mit-unicycle/mit-unicycle/docs/process/thanks.md

# Thanks

We want to warmly thanks Professor Christoph Koch, Federico Stella and the rest of the CS-358 TAs for the support and guidance they provided throughout the semester.  Also, many thanks to the staff of the SPOT. Without the help from all of this people, this project would have never come to fruition.

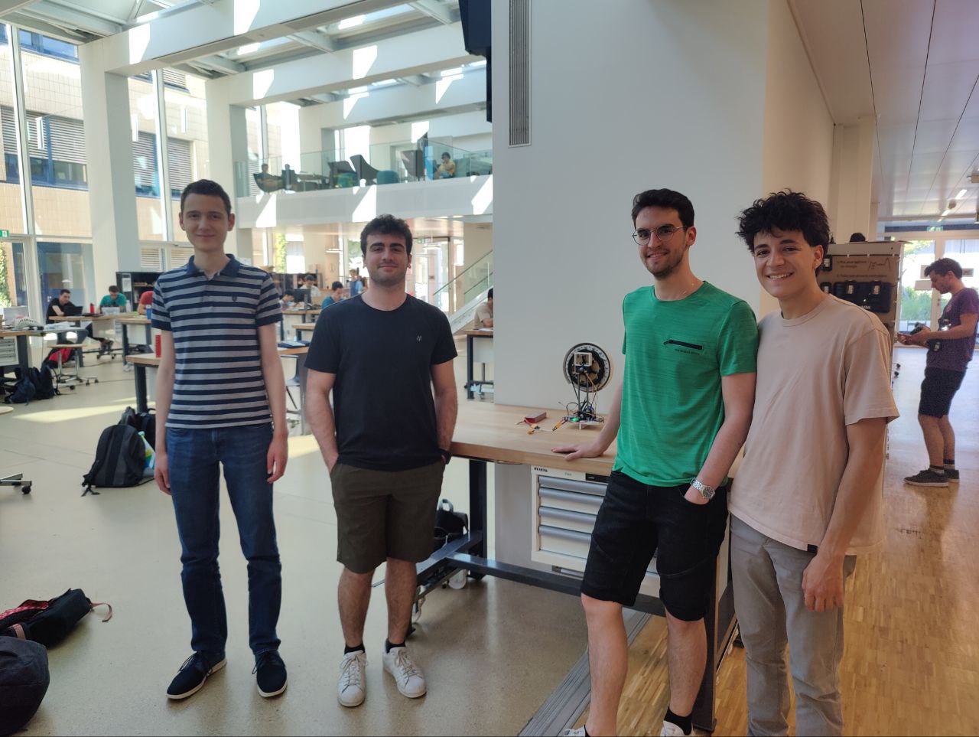
[picture p13: docs/images/dream_team.jpg]
The Dream Team


The Team being happy for the robot working just a few days before the deadline. 

----

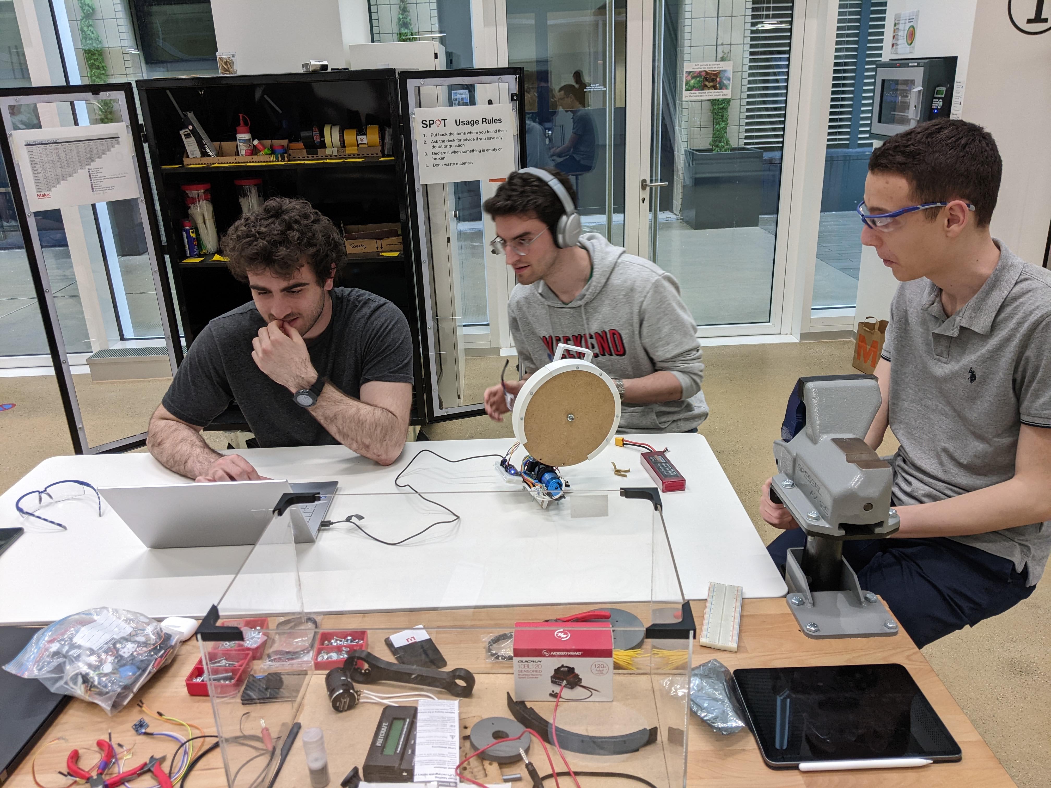
[picture p14: docs/images/dream_team_working.jpg]
The Dream Team Working


The Team Working Hard 🤓

----

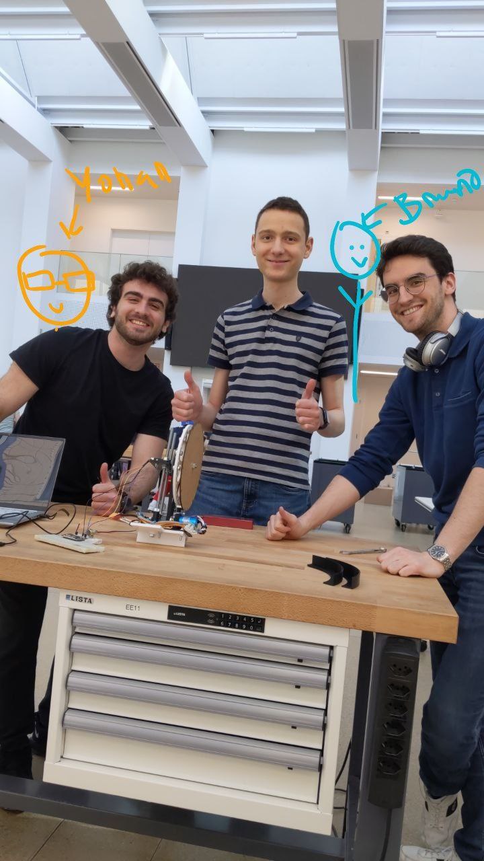
[picture p15: docs/images/dream_team2.jpg]
Dream Team 2


The Dream Team but incomplete
