mit-unicycle/mit-unicycle/docs/images/pid_overview.png

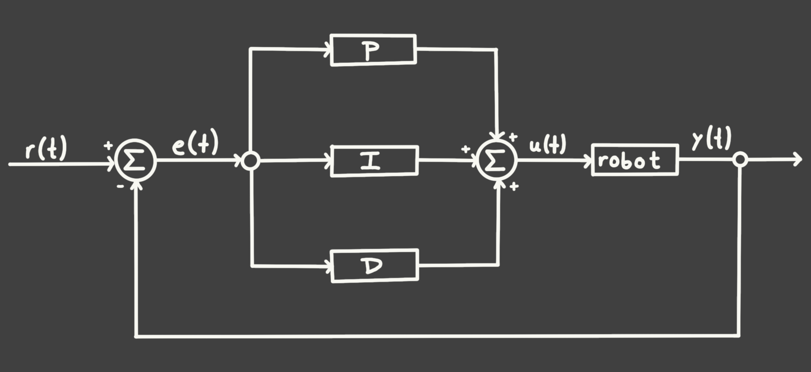
docs/images/pid_overview.png
