mit-unicycle/mit-unicycle/docs/images/torky.jpg

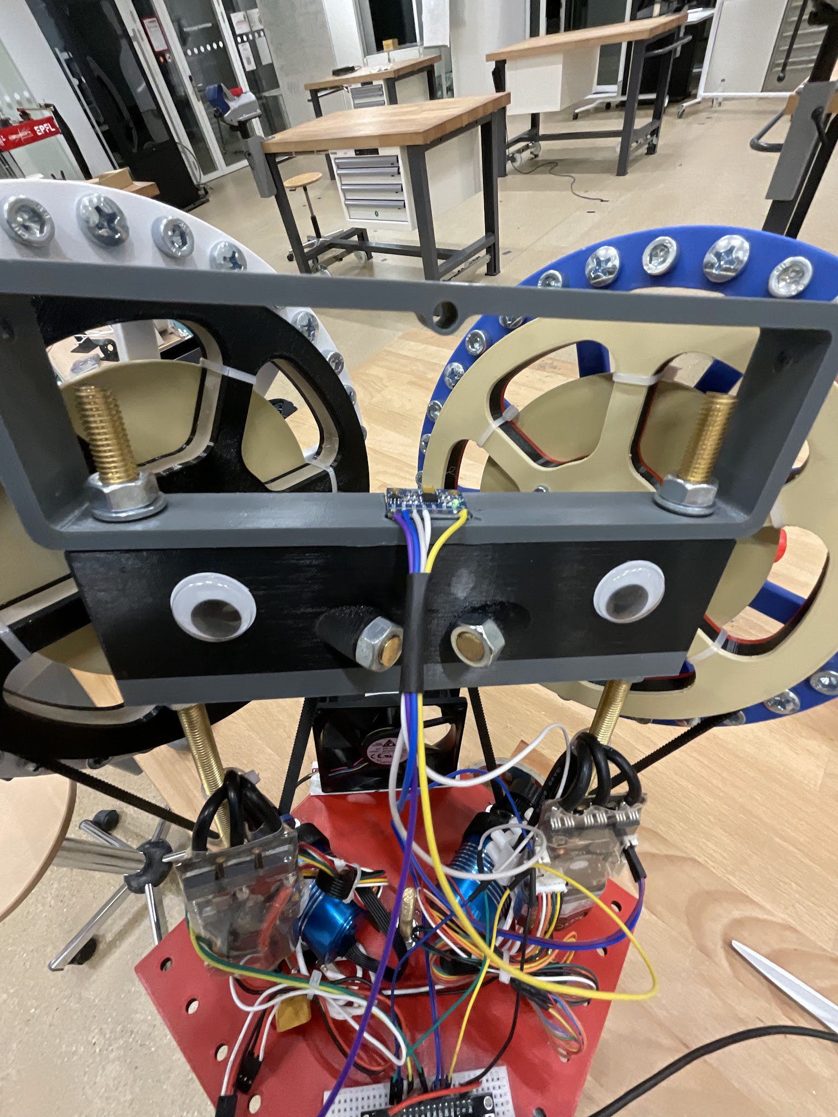
docs/images/torky.jpg
