mit-unicycle/mit-unicycle/docs/images/two_axesv1.jpg

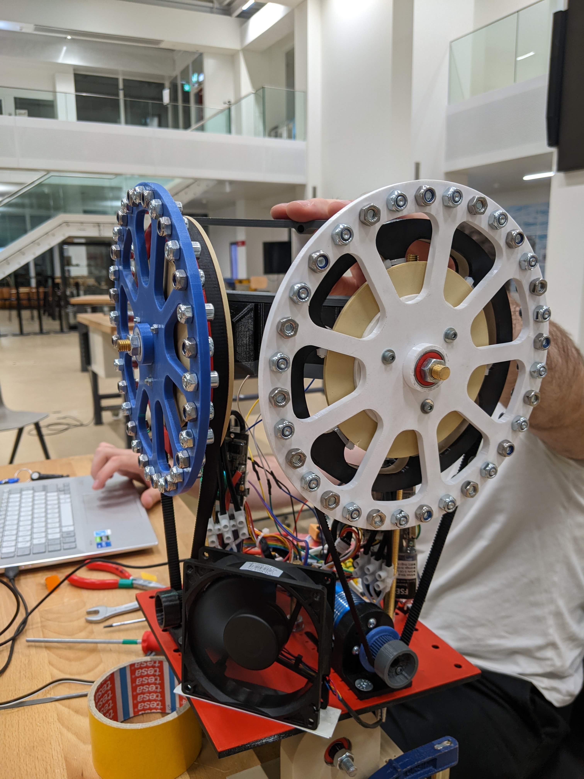
docs/images/two_axesv1.jpg
