mit-unicycle/mit-unicycle/docs/images/Manufacturing_images/graphs.png

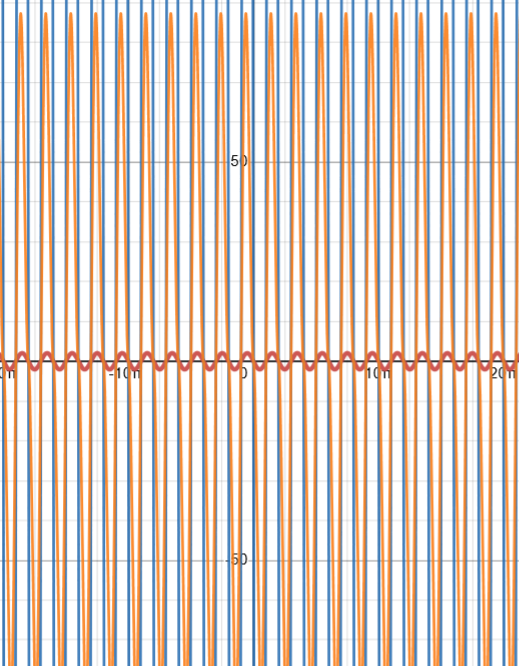
docs/images/Manufacturing_images/graphs.png
