mit-unicycle/mit-unicycle/docs/images/Manufacturing_images/GT2 reduction 7-1.png

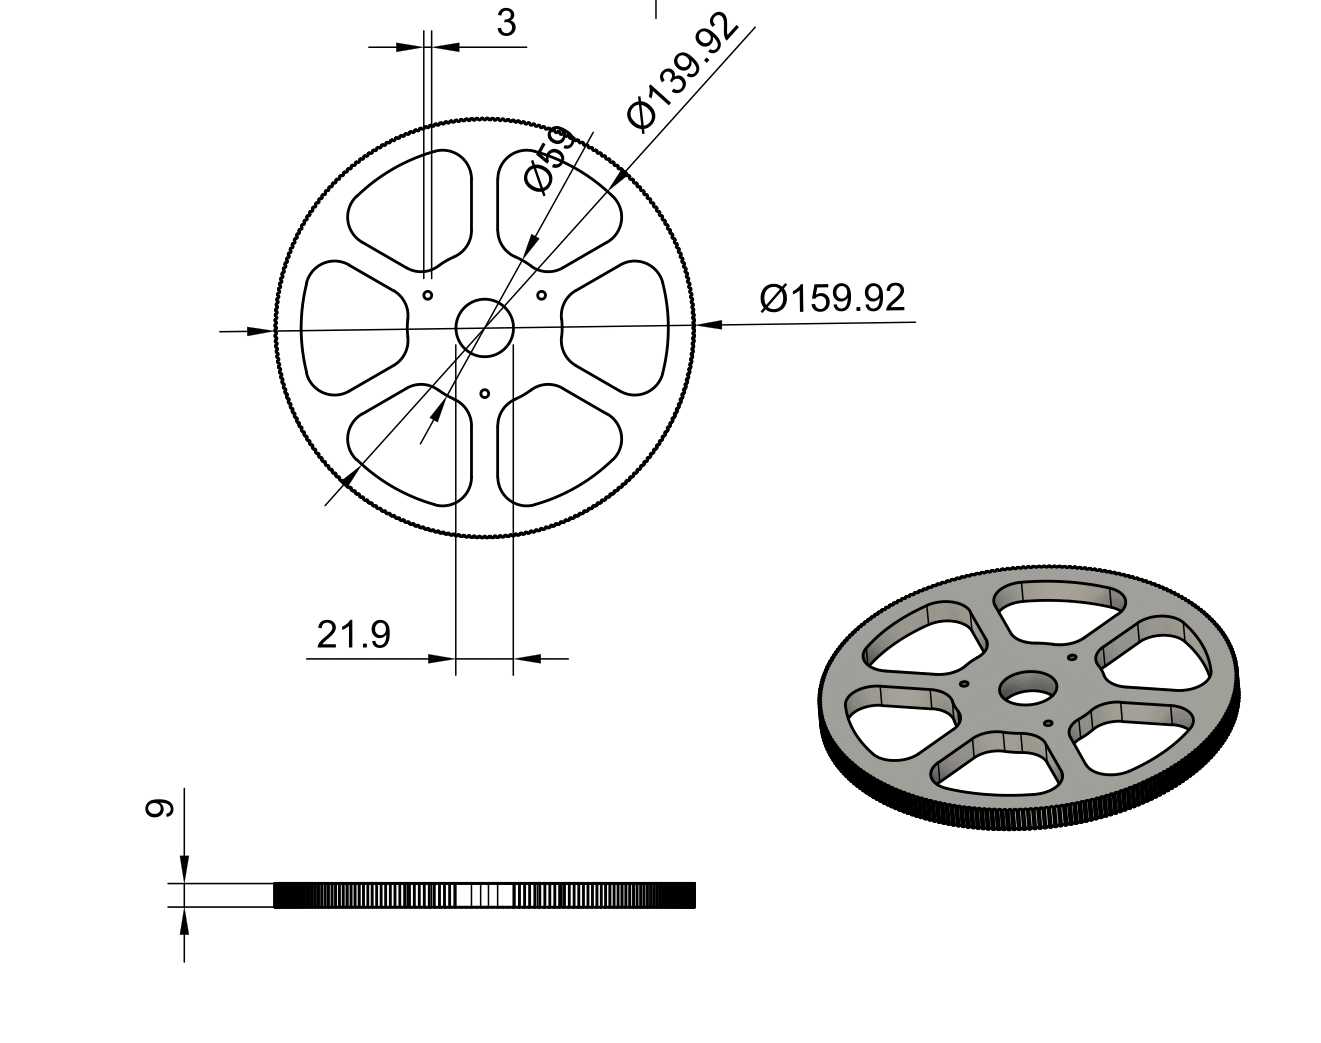
docs/images/Manufacturing_images/GT2 reduction 7-1.png
