mit-unicycle/mit-unicycle/docs/images/Manufacturing_images/Handle Drawing v1-1.png

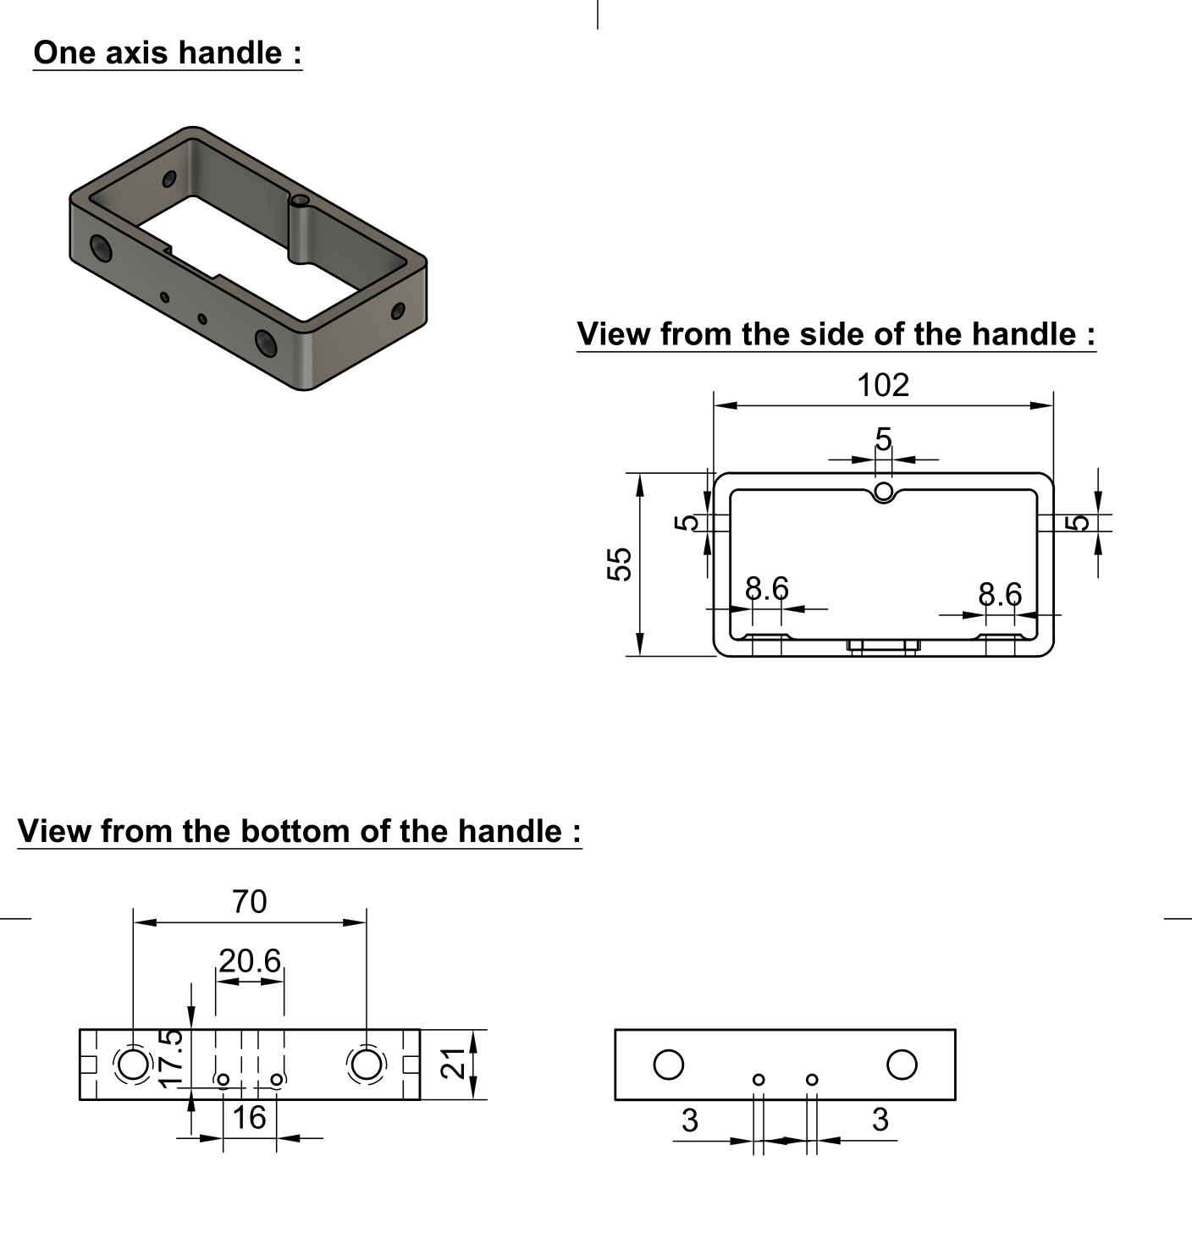
docs/images/Manufacturing_images/Handle Drawing v1-1.png
