mit-unicycle/mit-unicycle/todo.md

# TODO 

- Create an e-mail account that we will use for the project 
- Upload the demonstration video to youtube and add it to the home page 
- Add all the CAD files we used for the final prototype to github
- Improve the aesthetic of webpage
