mit-unicycle/mit-unicycle/(commit log)

2023-05-31 Working with the PID documentation
2023-05-31 manufacturing gt-2 pulley
2023-05-31 Components (#4)
    * DOCS: finished PID controller section
    * DOCS: finished PID controller section
    * DOCS: Had some merge conflicts, but now everything is nickel
    * DOCS: finished components.md
    ---------
2023-05-31 DOCS: finished PID controller section (#3)
    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
2023-05-31 Components (#5)
    * DOCS: finished componentd.md
    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
2023-06-01 Home page (#9)
    * Add motivation
    * add motiv
    * put youtube video
    * Do some stuff
    * remove .idea config
    * update gitignore
    * update nav structure
    * add github button
2023-06-01 First and second prototype document (#14)
    * test
    * images moved and manufacturing documentation updated
2023-06-02 Pid controller (#20)
    * Added dynamic setpoint explanation
    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
2023-06-02 Working on prototypes (#21)
2023-06-02 Wiring (#23)
    * Mostly finished wiring
    * Added wiring
    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
2023-06-02 Assembly instructions (#29)
    * synthax changes
    * images added, text updated
    * small changes manufacturing, image added
    * synthax changes
    * images added, text updated
    * gif of assembly added, Assembly instruction added
